CatXD/Invernadero_ESP32/Esquemas.pptx

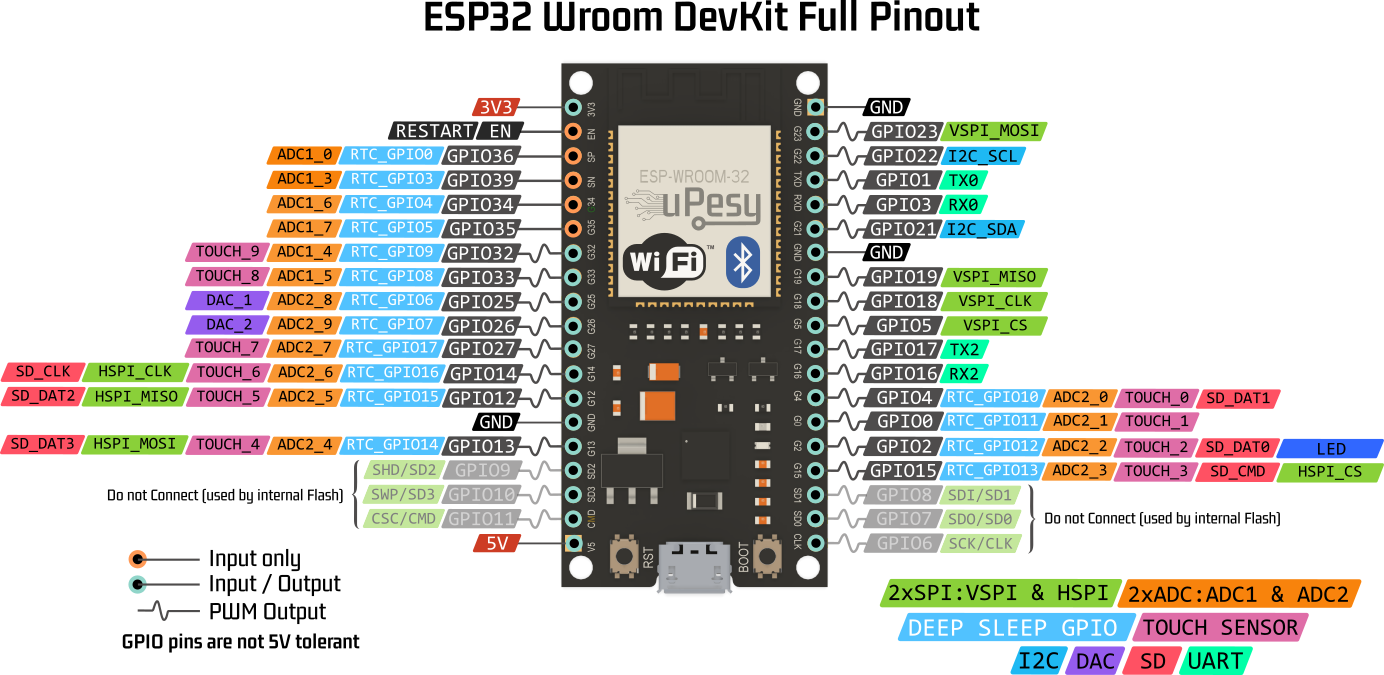
[picture p1: figure]
Use the GPIO pins of the ESP32

## Slide 2

Asignación de pines

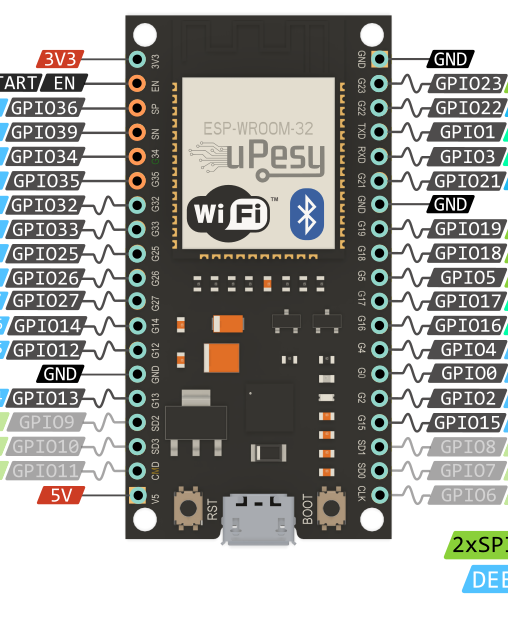
[picture p2: figure]
Use the GPIO pins of the ESP32

3.3
TECLADO_C1
TECLADO_C2
TECLADO_F1
TECLADO_F
ACT_RES14
ACT_RES16
ACT_LUZ
Este nada, que de normal tiene tensión –
PILOTO_LED
GND
DTH22
5V

GND
LCD – DIN
GND
LCD – DC
LCD – CLK
LCD – CE
LCD - LUZ
LCD - RST

## Slide 3

Bus Potencia - 12 V

Bus Control 3.3 V

CLK 18
DIN 23
DC 19
CE 5
RST 2

ESP32

LTO 3.3

SPI

DIO0*

5V

DIO14*

DIO32*

DIO33*

DI34**

DI35**

Invernadero

LEDS

Display
Nokia

5 V

4

Placa de Potencia

MOSFET

220

DO27

5K

Placa de Potencia

REG BUCK
5 V

Sens. Luz

Invernadero

Placa de Potencia

Resistencias 1
14 OHM 10 W

Resistencias 2
16 OHM 9 W

ADC

DHT22

DO TBD

BOTONERA

Piloto R1

Piloto poca humedad

Piloto Luz

ACEPTAR

Teclado matricial

CANCELAR

DO26

MOSFET

DO26

DO27

DO25

Piloto R2

+

DO25

MOSFET

*Etiqueta DIO - Cambia entre entrada y salida
** Solo Entradas

## Slide 4

Reloj Interno

Administrador Luz

Luz

Horario

Sensor luz

Termómetro

Administrador Temperatura

Célula Peltier

Aviso baja Temperatura

Medidor Humedad

Administrador Humedad

Aviso Riego

## LCD DE NOKIA

https://microcontrollerslab.com/nokia-5110-lcd-esp32-tutorial/

NOTAS:
La luz de fondo se conecta a masa a través de una resistencia. Para conmutarla -> a GPIO. Conmuto entre entrada(OFF)/salida(ON).

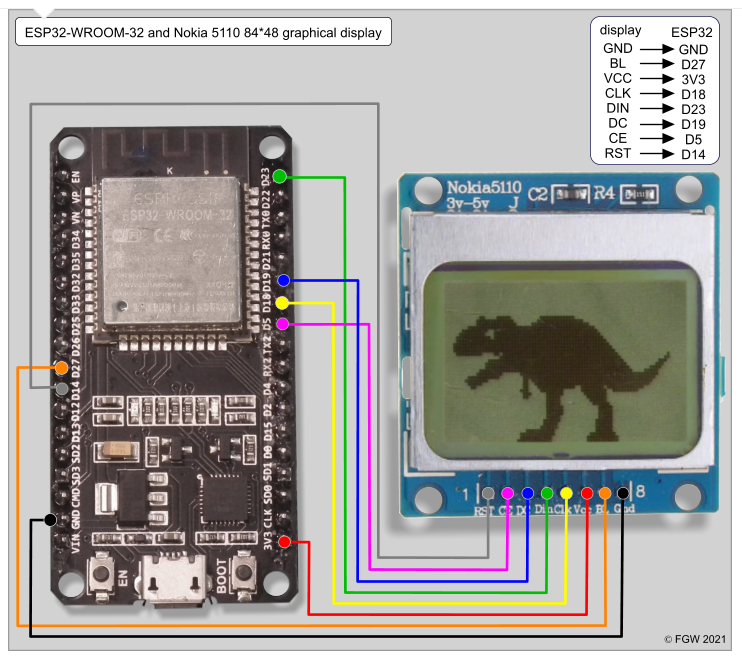
[picture p3: figure]
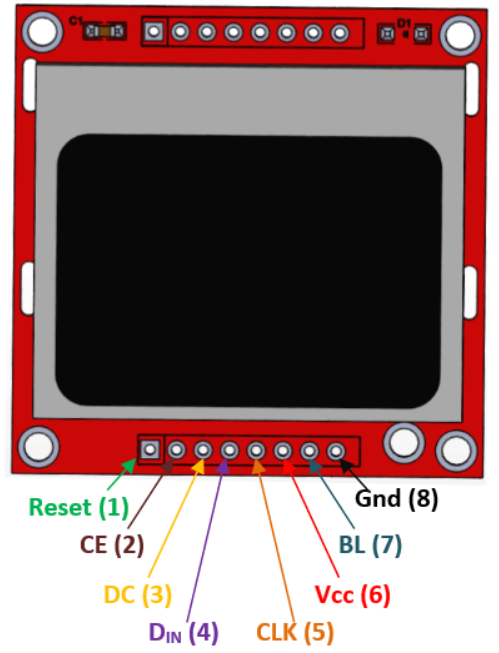
[picture p4: figure]

#include <SPI.h>

#include <Adafruit_GFX.h>

#include <Adafruit_PCD8544.h>

Adafruit_PCD8544 display = Adafruit_PCD8544(18,23,4,15,2);
Serial.begin(115200);
display.begin()
display.setContrast(50);
display.clearDisplay();
#DIBUJOS / TEXTO

display.display();
display.drawRect(20, 20, 50, 20, BLACK);
display.fillRect(20, 20, 50, 20, BLACK);
display.drawRoundRect(20, 20, 50, 20, 10, BLACK);
display.fillRoundRect(20, 20, 50, 20, 10, BLACK);
display.drawCircle(40, 20, 20, BLACK);
display.fillCircle(40, 20, 20, BLACK);
display.drawTriangle(40, 20, 20, 30, 50, 30, BLACK);
display.fillTriangle(40, 20, 20, 30, 50, 30, BLACK);
display.drawBitmap(0, 0, bitmap_image_en_array, 84, 48, 1);

display.clearDisplay();
display.setTextSize(1); display.setTextColor(BLACK); display.setCursor(10,10); display.println(“¡Hola!”);
display.display();

## Slide 6

Bucle principal de control

Menú (Bloqueante)

Hay que configurar modo de funcionamiento:
Luz + Calor / Sólo Calor

Leer sensor DTH22

Revisar Temperatura

Ence./Apag. Resistencia 1

Tecla pulsada

Acepar pulsado

Mostrar hora, temp y luz 5 s

Cancelar

Aceptar

2 s

Tecla +

Ence./Apag. Resistencia 2

Apagar pantalla

Tecla -

Luz + Calor

Sólo Calor

## Slide 7

Bucle principal de control

Menú (Bloqueante)

Hay que configurar modo de funcionamiento:
Luz + Calor / Sólo Calor

Introducir Fecha

Revisar hora

Leer sensor DTH22

Revisar Temperatura

Leer sensor Luz

Bloquear Resistencia 2

Tecla pulsada

Acepar pulsado

Mostrar hora, temp y luz 5 s

Cancelar

Aceptar

Revisar Humedad

Revisar si está la luz dada

Ence./Apag. Resistencia 1

Encender piloto aviso

2 s

Tecla +

Ence./Apag. Luz

Apagar pantalla

Tecla -

Ence./Apag. Resistencia 2

Luz + Calor

Sólo Calor

## Slide 8

Librería del RTC interno

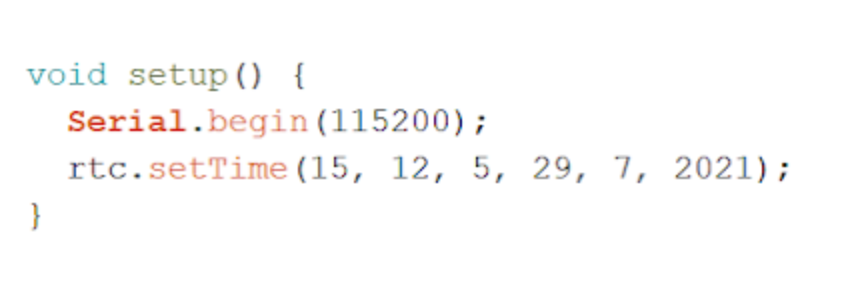
[picture p5: figure]

setTime(30, 24, 15, 17, 1, 2021); // 17-1-2021 15:24:30 -> El que hizo la librería también tenía sus taras mentales

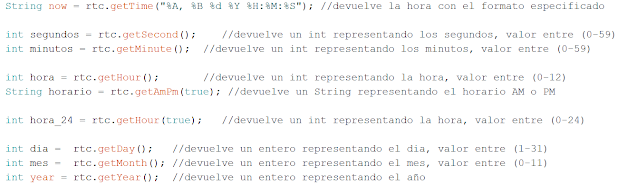
[picture p6: figure]

getTime("%A, %B %d %Y %H:%M:%S")

https://github.com/fbiego/ESP32Time

## Slide 9

Main
Tiempo_t Tiempo

Control
Init()
Ejecutar(Tiempo_t time)*
HabilitarLuz(bool)*
Bool GetEstadoR1()*
Bool GetEstadoR2()*
Bool GetEstadoLuz()*
Bool GetAlarmaHumedad()*
Bool GetNocheDia()*
Int GetValorSensor()*
float GetTemp()*
float GetHumedad()*

MenuConfiguracion.h
SetHora()

Control_Temp
Init()
Ejecutar(Tiempo_t time, temp, bool EstadoLuz)
BloqueoResistencia(bool)
Bool EstadoR1
Bool EstadoR2

1

2

Resistencia
Bloqueo (bool)
Encender(bool)
SetPin(int)
Estado

DHT22

1

1

LUZ
Encender(bool)
SetPin(int)
Estado

SensorLUZ

CurvasLuz.h
float CalcHoraAmanecer (int mes, int dia)
float CalcHoraAnochecer (int mes, int dia)

Control_Luz
Init()
Ejecutar(Tiempo_t time)
Habilitar (bool)
Bool GetEstadoLuz()
Bool GetNocheDia()
Int GetValorSensor()

Botonera
EncenderLed(bool)
tecla_t MuestrearBotonera()

1

1

UI
Void DisplayInit()

LCD

RTC

MiRTC
Void DisplayInit()

*Protegidas con mutex
