CatXD/Invernadero_ESP32/codigo fuente/proyecto_Arduino/control.cpp

#include "control.h"

void Control::Init ()
{
  ctrl_luz.Init();
  mutexEstado = xSemaphoreCreateMutex();
  mutexCtrl = xSemaphoreCreateMutex();
}

EstadoControl_t Control::EjecutarCicloControl(Tiempo_t tiempo)
{
  Ctrl_luzMasTemp_estado_t reporte_luzMasTemp;

  EstadoControl_t nuevo_estado;
  bool esDeDia;

  //Calculo si es de dia o de noche
  float hora_amanecer = CalcHoraAmanecer(tiempo.mes, tiempo.dia);
  float hora_anochecer = CalcHoraAnochecer(tiempo.mes, tiempo.dia);
  esDeDia = ((tiempo.hora + tiempo.min/60.0) > hora_amanecer) && ((tiempo.hora + tiempo.min/60.0) < hora_anochecer);

  xSemaphoreTake( mutexCtrl, portMAX_DELAY );

  //Ejecucion control Luz
  reporte_luzMasTemp = ctrl_luz.Ejecuta_Control(esDeDia);



  xSemaphoreGive( mutexCtrl );
  
  nuevo_estado.Estado_Temp = reporte_luzMasTemp.estado_ctrl_temp;
  nuevo_estado.Estado_Luz = reporte_luzMasTemp.estado_ctrl_luz;
  nuevo_estado.Fecha = tiempo;
  nuevo_estado.DiaNoche = esDeDia;
  nuevo_estado.HoraAmanecer = hora_amanecer;
  nuevo_estado.HoraAnochecer = hora_anochecer;
  SetEstado(nuevo_estado);
  return nuevo_estado;
}

void Control::HabilitarLuz(bool en)
{
  ctrl_luz.SetLuzHabilitada(en);
}

bool Control::GetHabilitacionLuz()
{
return ctrl_luz.GetLuzHabilitada();  
}

EstadoControl_t  Control::GetEstado()
{
  EstadoControl_t estado;
  xSemaphoreTake( mutexEstado, portMAX_DELAY );
  estado = Estado;
  xSemaphoreGive( mutexEstado );
  return estado;
}
void  Control::SetEstado(EstadoControl_t estado)
{
  xSemaphoreTake( mutexEstado, portMAX_DELAY );
  Estado = estado;
  xSemaphoreGive( mutexEstado );
}
