CatXD/Invernadero_ESP32/codigo fuente/proyecto_Arduino/def_pines.h

#include <Arduino.h>
#include <sdkconfig.h>
#include <esp_system.h>


#ifndef DEFPINES_H
#define DEFPINES_H


#define LCD_CLK 18
#define LCD_DIN 23
#define LCD_DC 19
#define LCD_CE 5
#define LCD_RST 2
#define LCD_LIGHT 0

#define DHT_PIN 13

#define ACT_Res14 25
#define ACT_Res16 26
#define ACT_Luz 27


#define TECLADO_NUM_FILAS 2
#define TECLADO_NUM_COLUM 2
#define TECLADO_F1 32
#define TECLADO_F2 33
#define TECLADO_C1 34 //Input only
#define TECLADO_C2 35 //Input only

#define PILOTO 12







#endif
