CatXD/Invernadero_ESP32/(commit log)

2023-03-03 Añadida botonera. CompOK, DebugX
    Arreglado OUTPUT pinMode... no declarados
    Actualizada PPT.
    No probado sobre placa
    [botonera.cpp, botonera.h, def_pines.h, interfaz_hm.cpp, interfaz_hm.h]
2023-03-04 Arreglados bugs de botonera y luz Display
    [botonera.cpp, botonera.h, interfaz_hm.cpp, interfaz_hm.h, proyecto_Arduino.ino]
2023-03-06 Esta funcionando
    Voy a establecer una relacion de agregacion entre el control de temperatura y de la luz para hacer el bloqueo de R2
2023-03-06 Arreglado N/D CompOK DebugOK
    [control.cpp, control.h, control_luz.cpp, control_temp.cpp, control_temp.h, interfaz_hm.cpp]
2023-03-06 Añadida regresion Amanecer y Anochecer
    [RegresionHorasAmanecerAnochecer.xlsx]
